AklRoman/Clever_predprof/Электроника/Архив/Монтажная схема компонентов турели.jpg

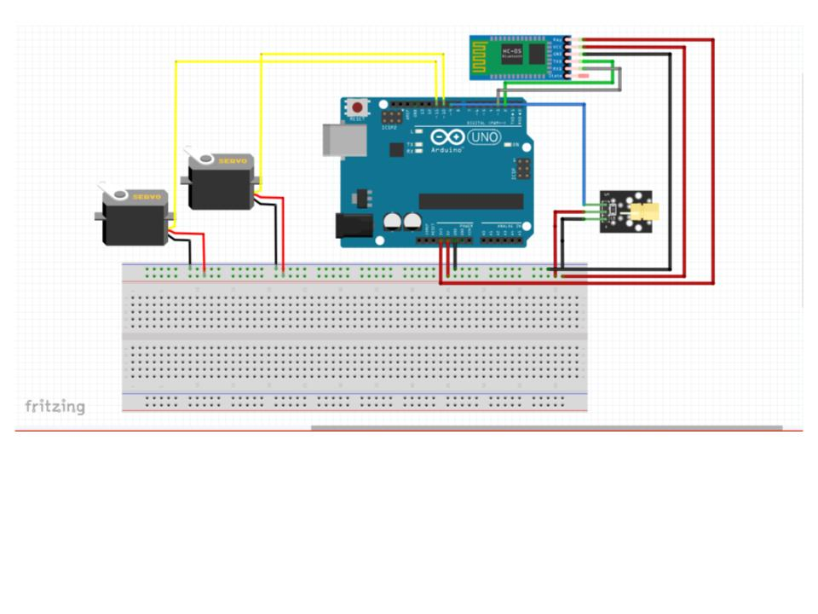
Электроника/Архив/Монтажная схема компонентов турели.jpg
