AklRoman/Clever_predprof/Электроника/Архив/Монтажная схема ардуино.docx

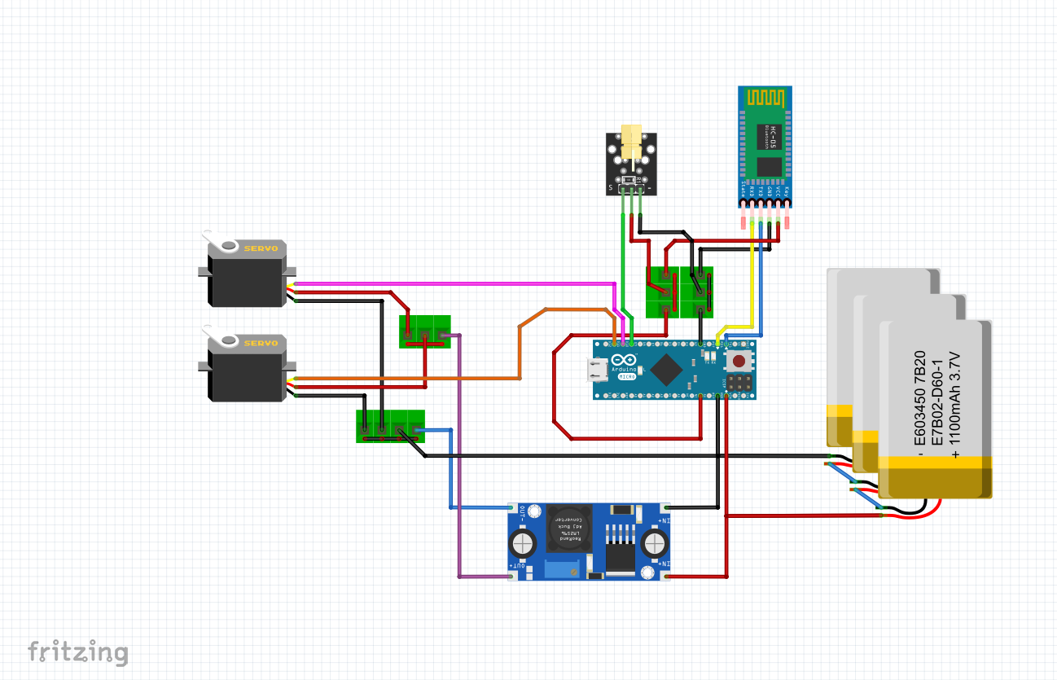
[picture p6: figure]
