AklRoman/Clever_predprof/Электроника/Архив/Монтажная схема турель.docx

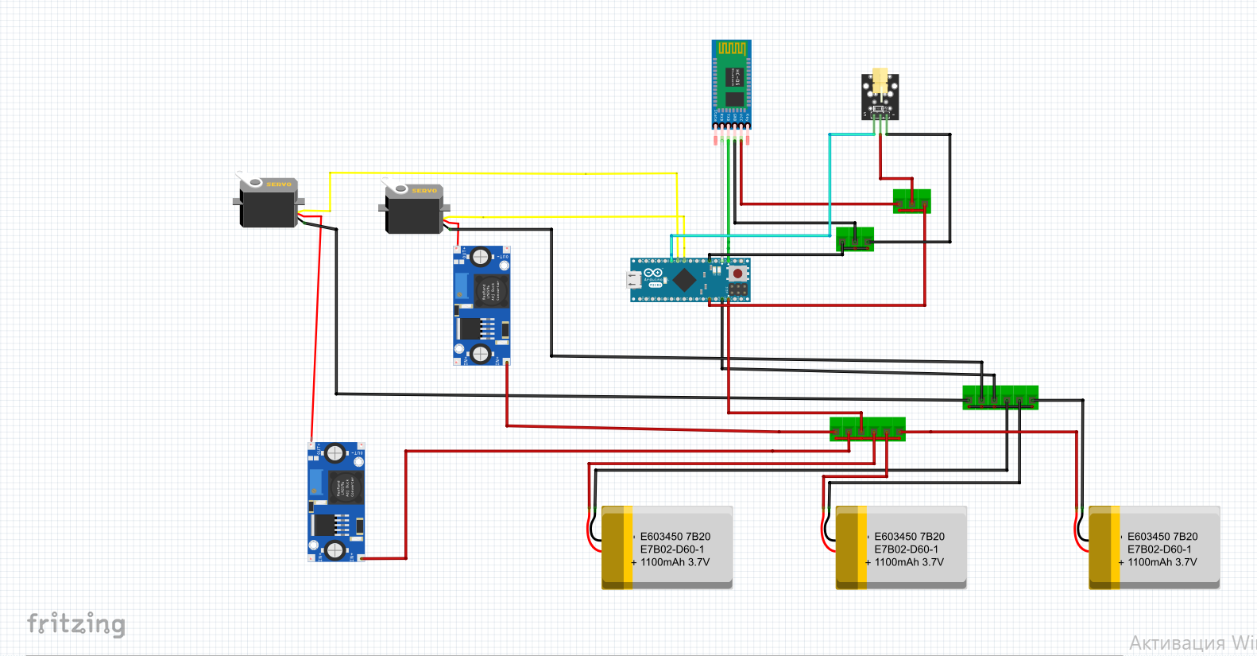
[picture p7: figure]
