AklRoman/Clever_predprof/Электроника/Архив/монтажная схема.docx

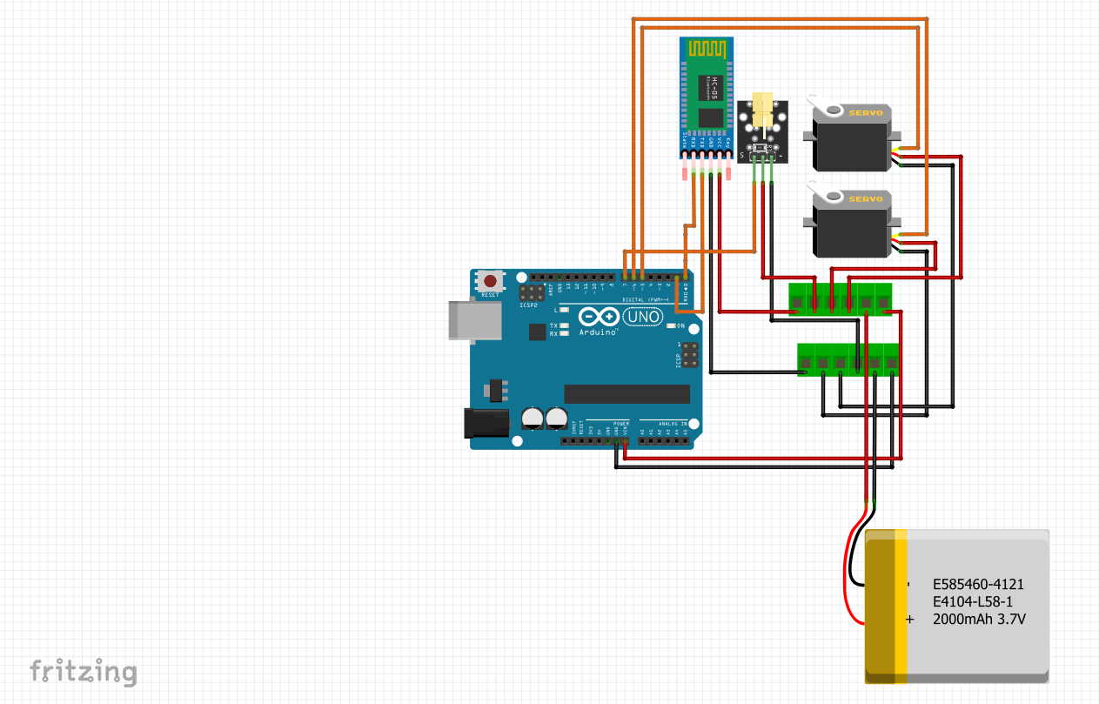
[picture p8: figure]
