AklRoman/Clever_predprof/ПО/PNG диаграммы состояний/State machine-Подсистема возврата.png

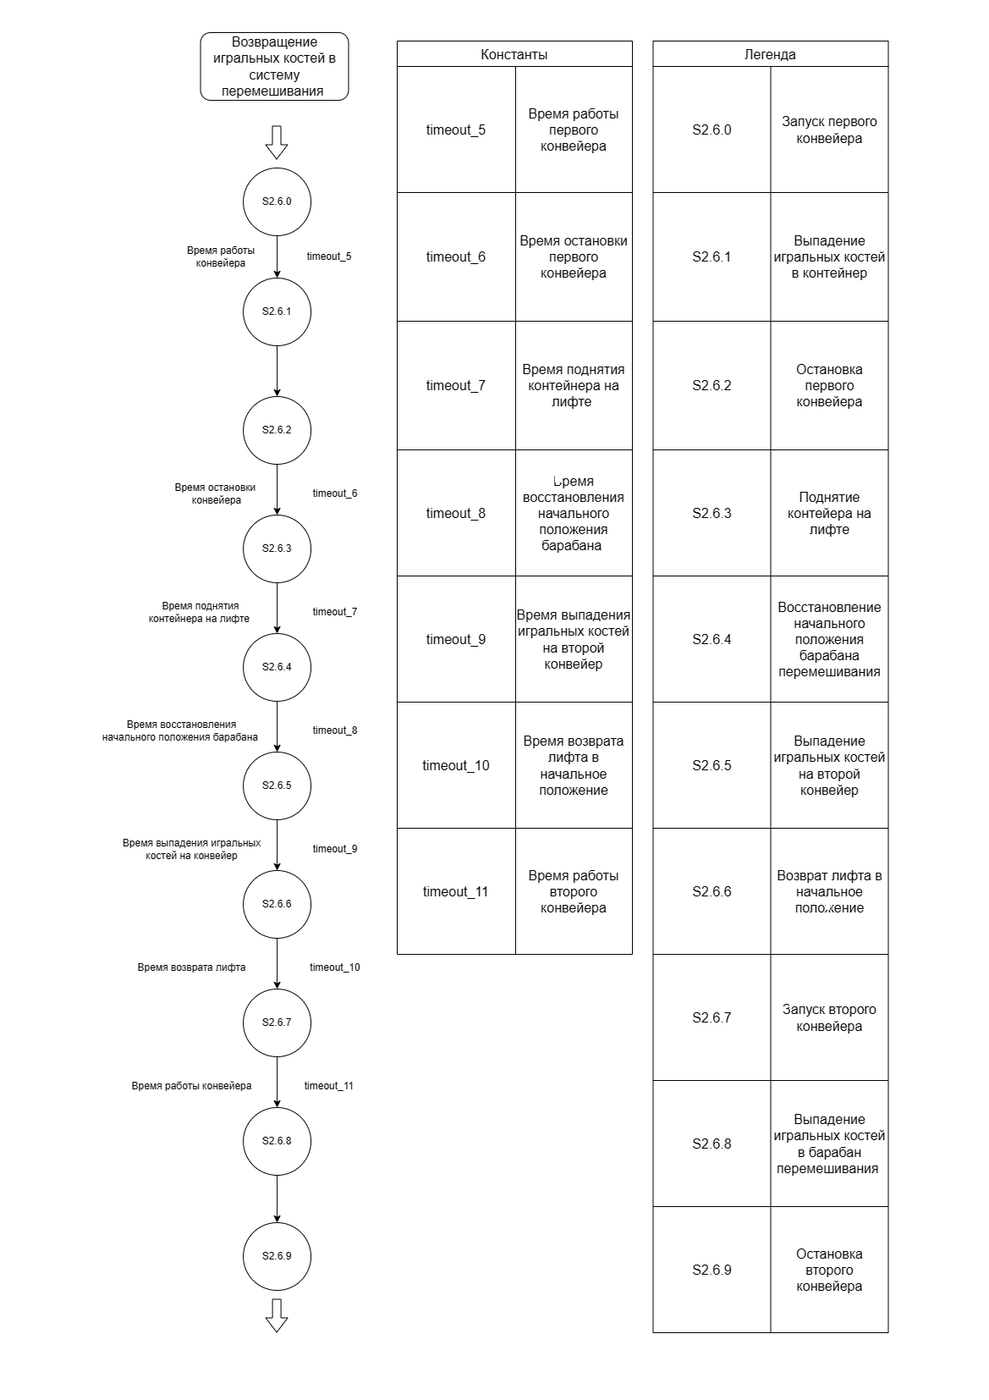
ПО/PNG диаграммы состояний/State machine-Подсистема возврата.png
