AklRoman/Clever_predprof/ПО/PNG диаграммы состояний/State machine-Проверка начального состояния.png

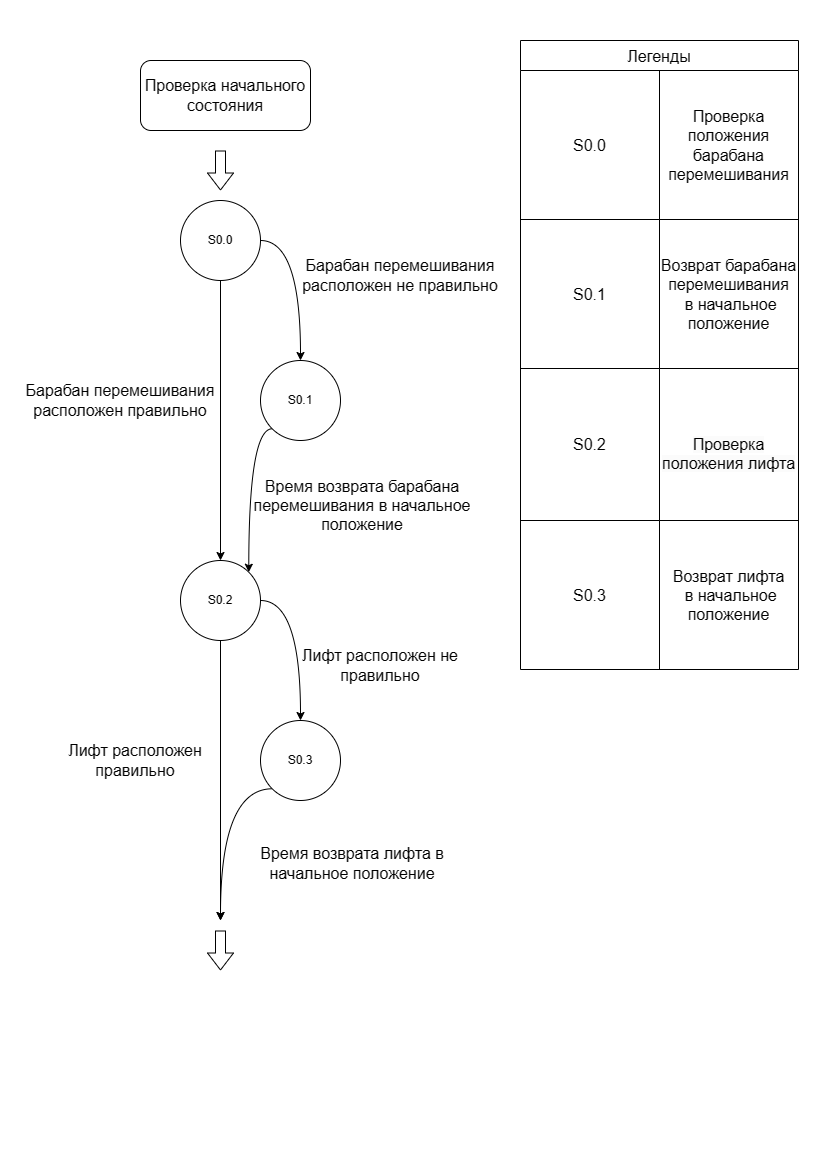
ПО/PNG диаграммы состояний/State machine-Проверка начального состояния.png
