AklRoman/Clever_predprof/ПО/PNG диаграммы состояний/State machine-Работа одного цикла.png

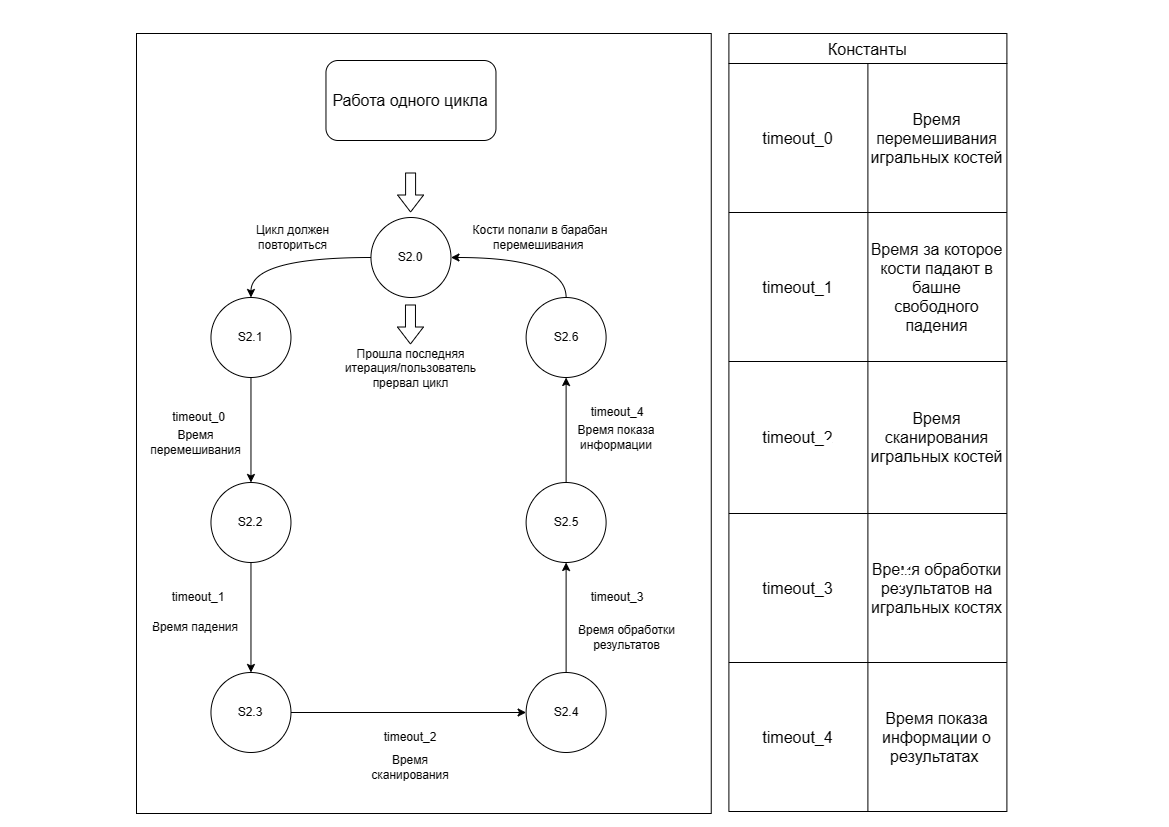
ПО/PNG диаграммы состояний/State machine-Работа одного цикла.png
