AklRoman/Clever_predprof/ПО/PNG диаграммы состояний/State machine-Разовые запуски подсистем.png

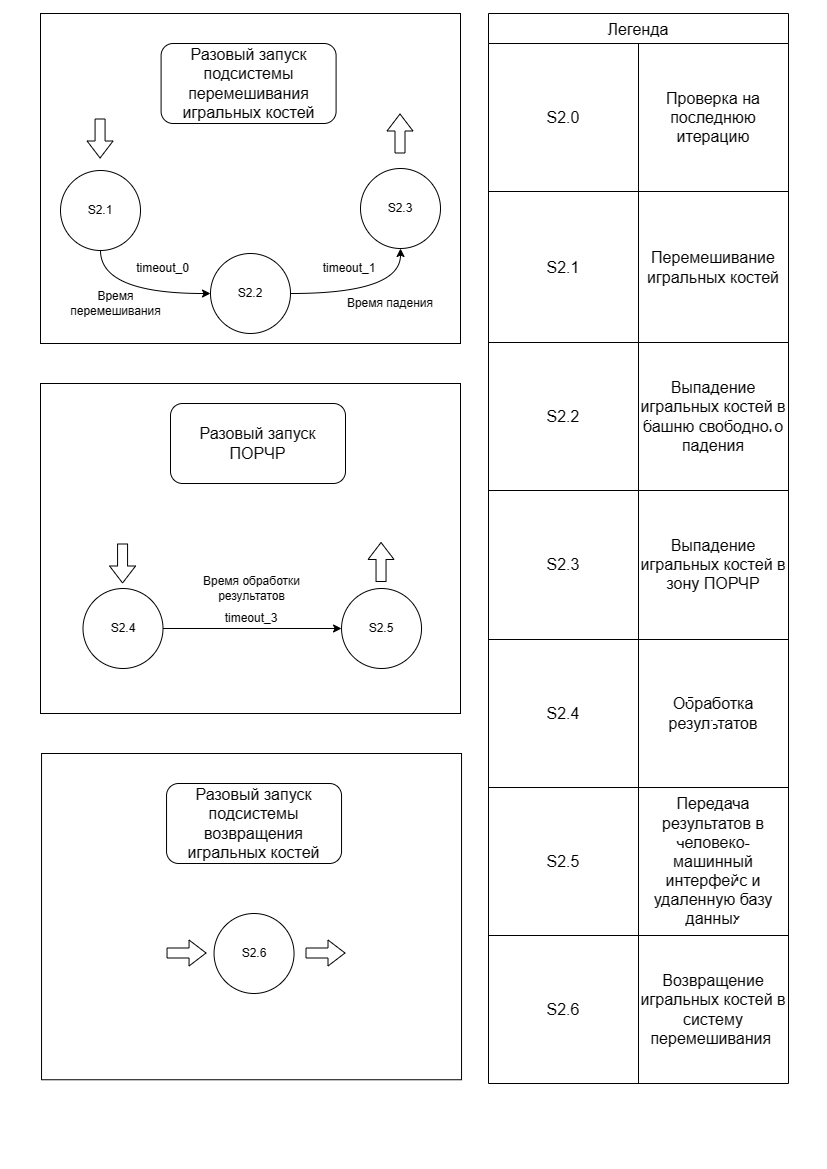
ПО/PNG диаграммы состояний/State machine-Разовые запуски подсистем.png
