AklRoman/Clever_predprof/ПО/PNG диаграммы состояний/State machine-Состояния, задаваемые пользователем.png

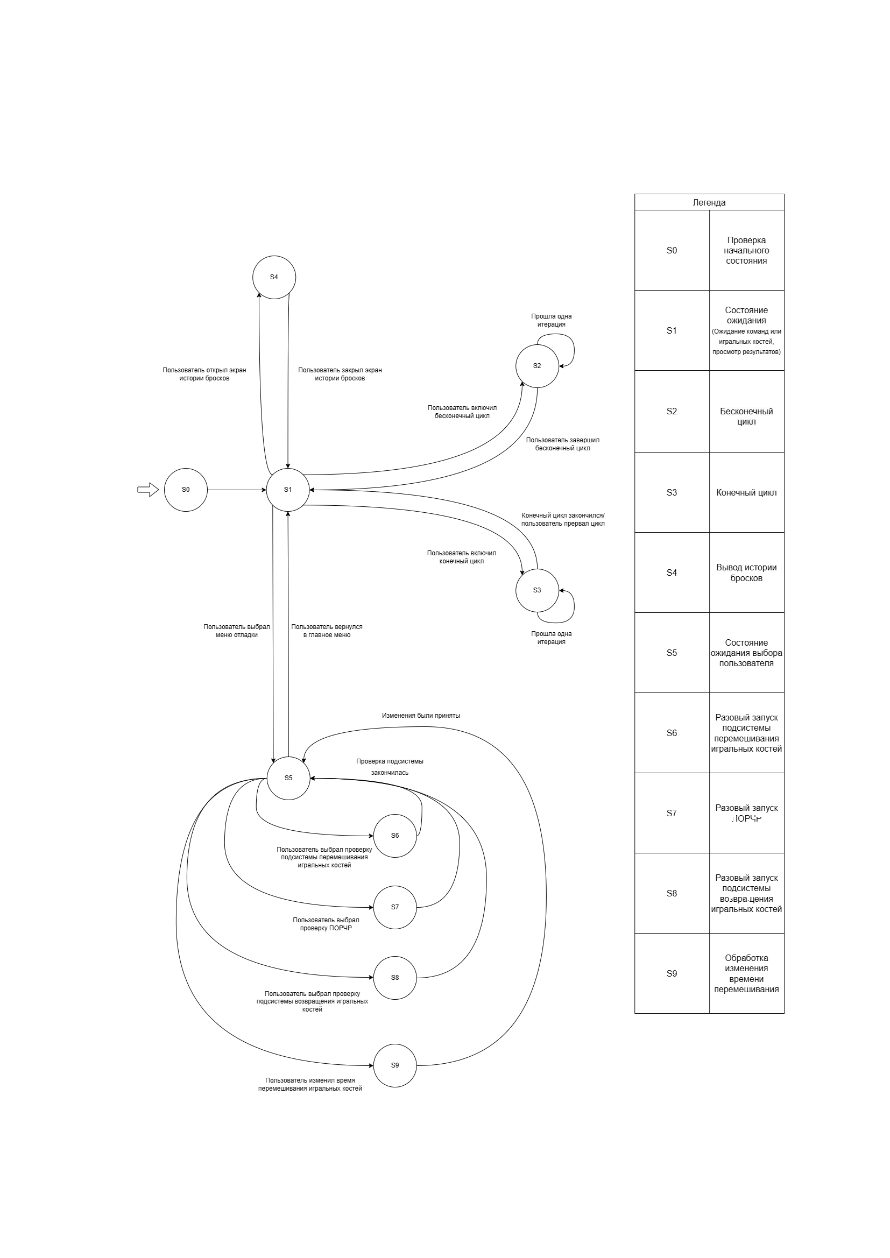
ПО/PNG диаграммы состояний/State machine-Состояния, задаваемые пользователем.png
