AklRoman/Clever_predprof/ПО/User case.png

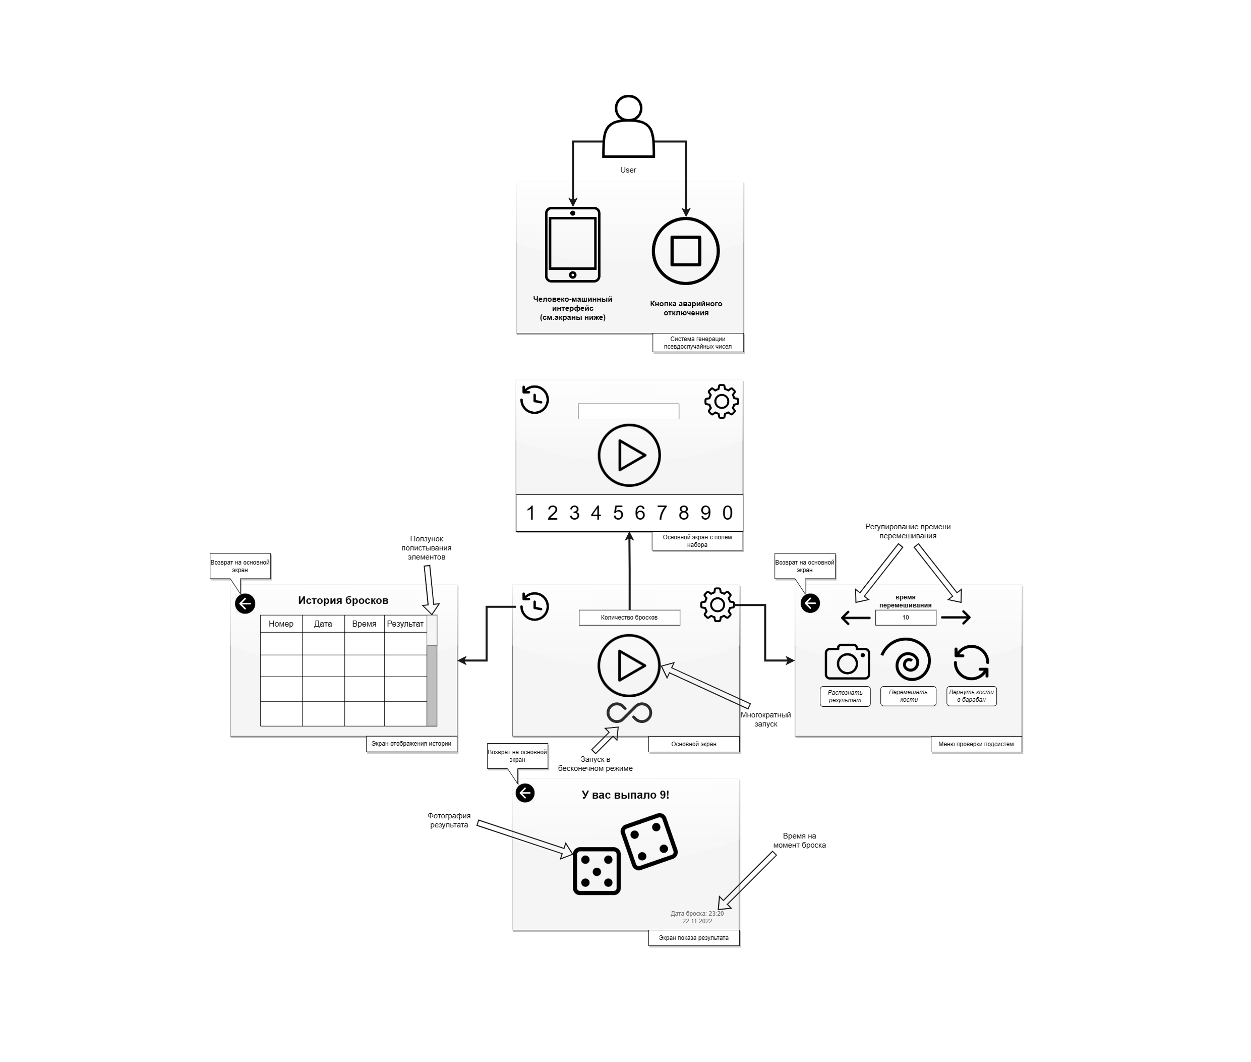
ПО/User case.png
