AklRoman/Clever_predprof/ПО/Блок-схемы/Блок-схема-onetimelaunch_ handler(cmd);.png

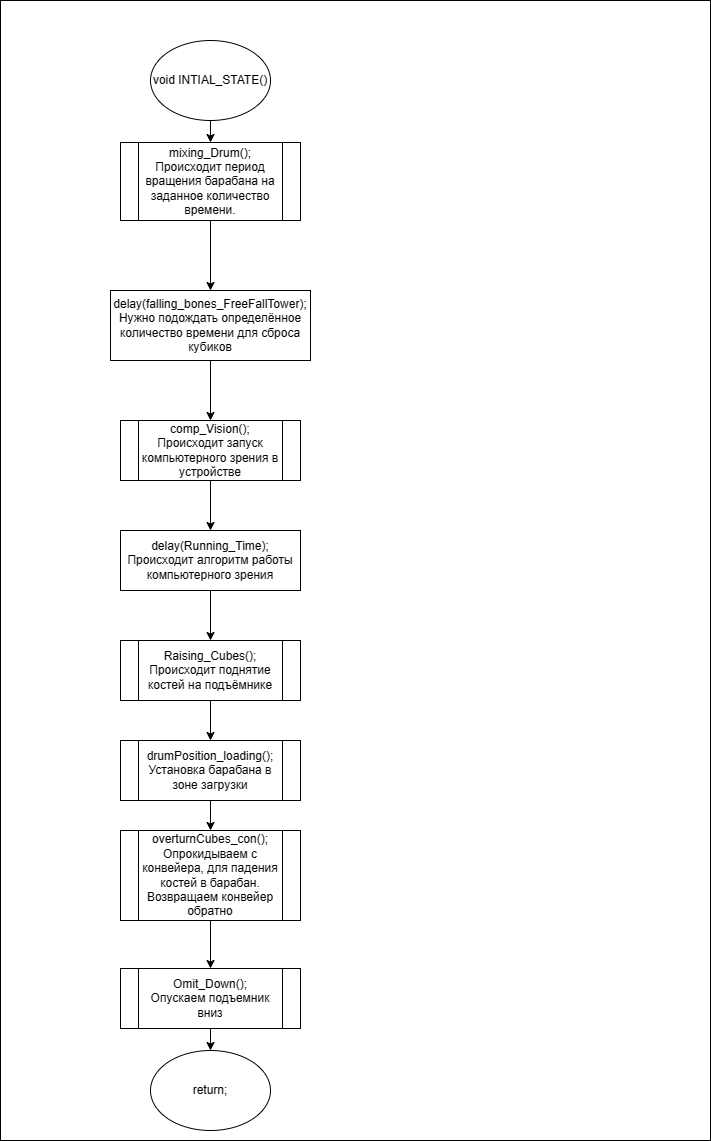
ПО/Блок-схемы/Блок-схема-onetimelaunch_ handler(cmd);.png
