AklRoman/Clever_predprof/ПО/Блок-схемы/Блок-схема-void loop().png

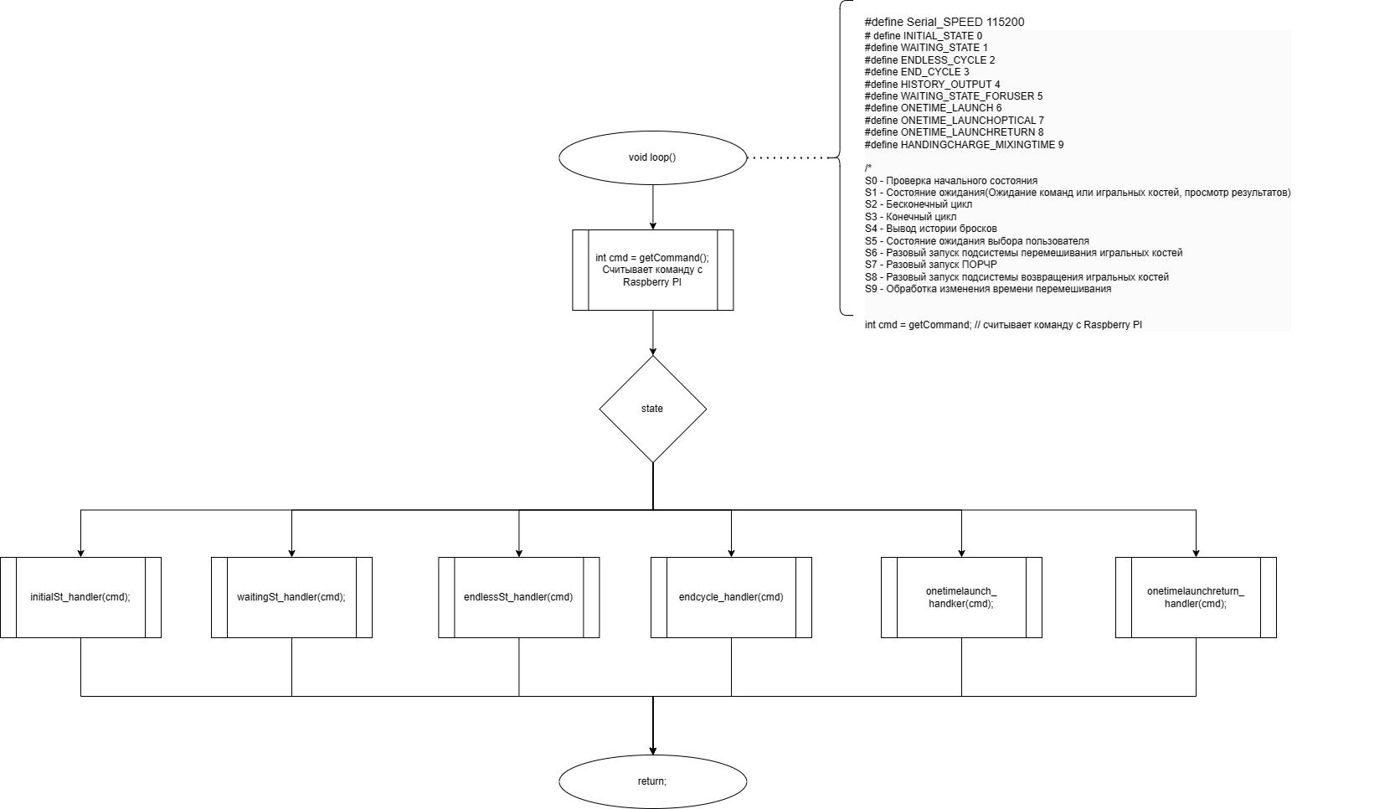
ПО/Блок-схемы/Блок-схема-void loop().png
