AklRoman/Clever_predprof/ПО/Диаграмма последовательности.drawio.png

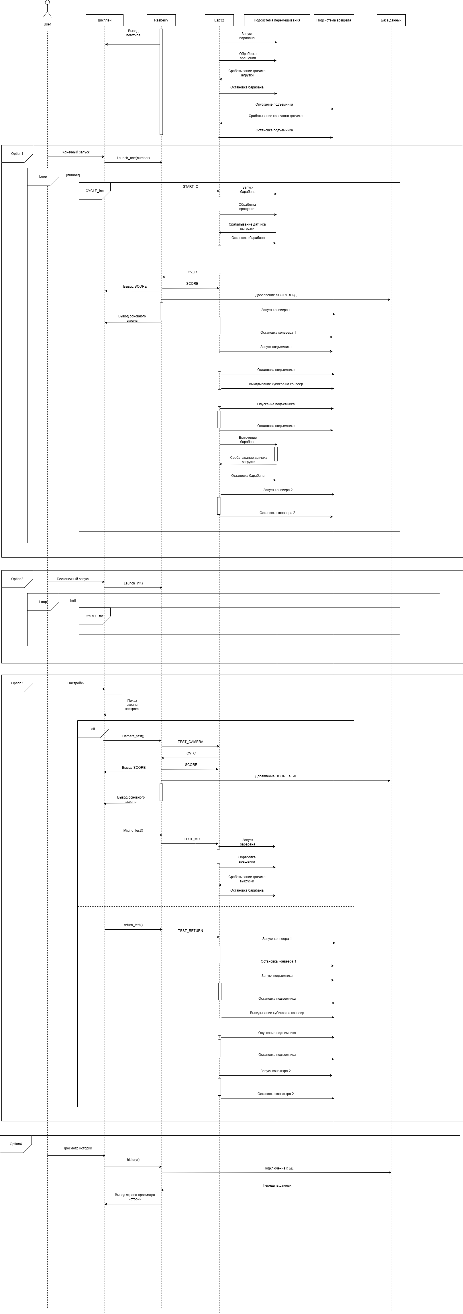
ПО/Диаграмма последовательности.drawio.png
