AklRoman/Clever_predprof/Электроника/Архив/Принципиальная схема компонентов турели.jpg

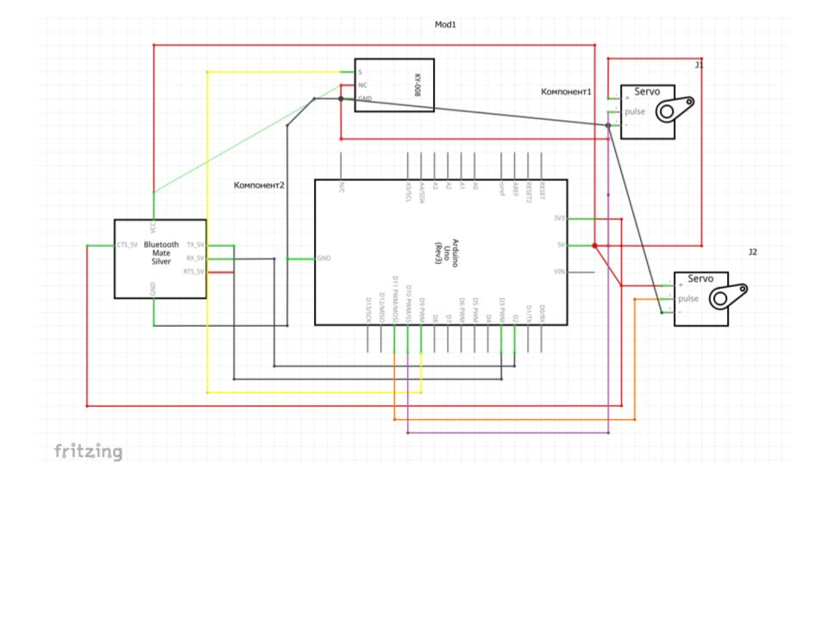
Электроника/Архив/Принципиальная схема компонентов турели.jpg
