AklRoman/Clever_predprof/(list of files, cad)

Other CAD files:
3D дизайн/сборка барабана v3.f3z
