AklRoman/Clever_predprof/Электроника/МС_МП.pdf

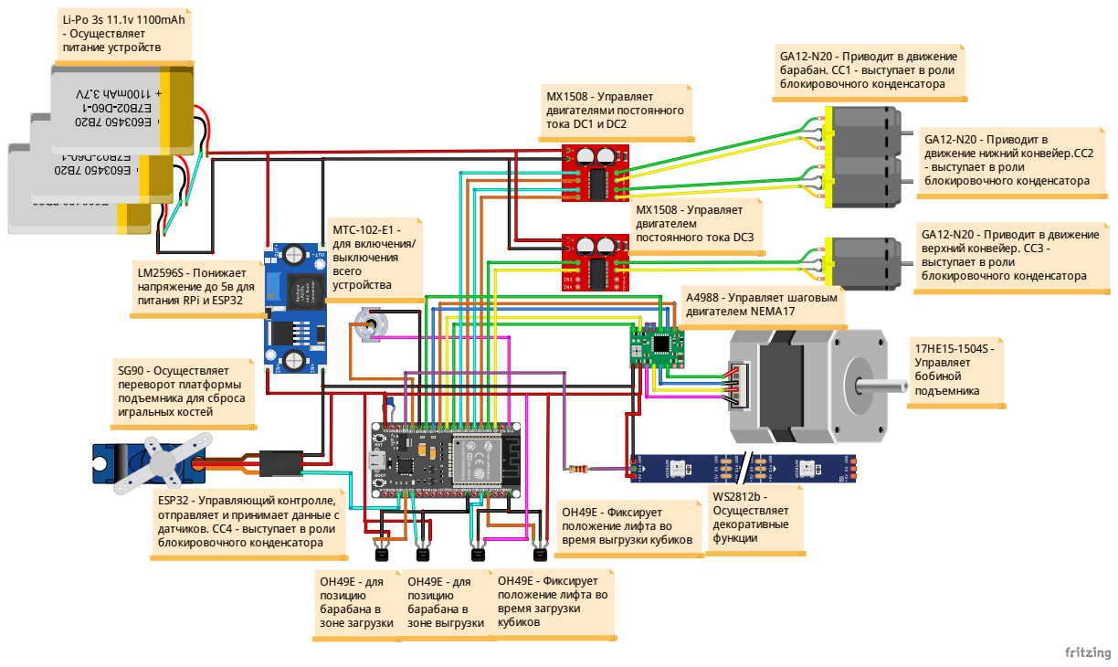
[picture p19: page 1]
Li-Po 3s 11.1v 1100mAh - Осуществляет питание устройств; MTC-102-E1 - для включения/ выключения всего устройства; OH49E - для позицию барабана в; зоне загрузки; зоне выгрузки; WS2812b - Осуществляет декоративные функции; MX1508 - Управляет двигателями постоянного тока DC1 и DC2; MX1508 - Управляет двигателем постоянного тока DC3; GA12-N20 - Приводит в движение верхний конвейер. CC3 -; выступает в роли блокировочного конденсатора; A4988 - Управляет шаговым двигателем NEMA17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

GA12-N20 - Приводит в движение
барабан. CC1 - выступает в роли
блокировочного конденсатора

GA12-N20 - Приводит в
движение нижний конвейер.CC2
- выступает в роли

LM2596S - Понижает
напряжение до 5в для
питания RPi и ESP32

SG90 - Осуществляет
переворот платформы
подъемника для сброса
игральных костей

ESP32 - Управляющий контролле,
отправляет и принимает данные с
датчиков. CC4 - выступает в роли

OH49E - Фиксирует
положение лифта во
время выгрузки кубиков

время загрузки
кубиков
