AklRoman/Clever_predprof/Электроника/ТЗ Принципиальная схема.pdf

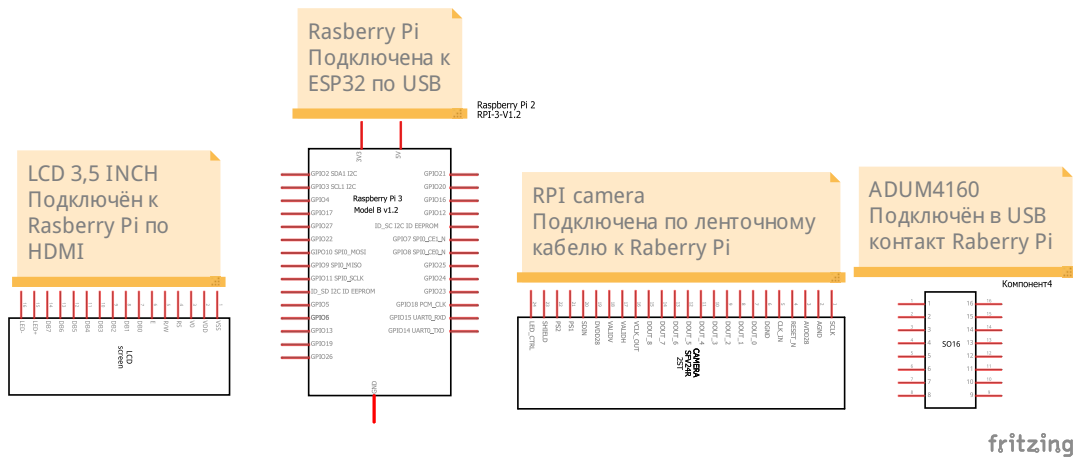
[picture p20: page 1]
Rasberry Pi Подключена к ESP32 по USB

LCD 3,5 INCH
Подключён к
Rasberry Pi по
HDMI

ADUM4160
Подключён в USB
контакт Raberry Pi

RPI camera
Подключена по ленточному
кабелю к Raberry Pi
