AklRoman/Clever_predprof/Электроника/Архив/Micro_МП.pdf

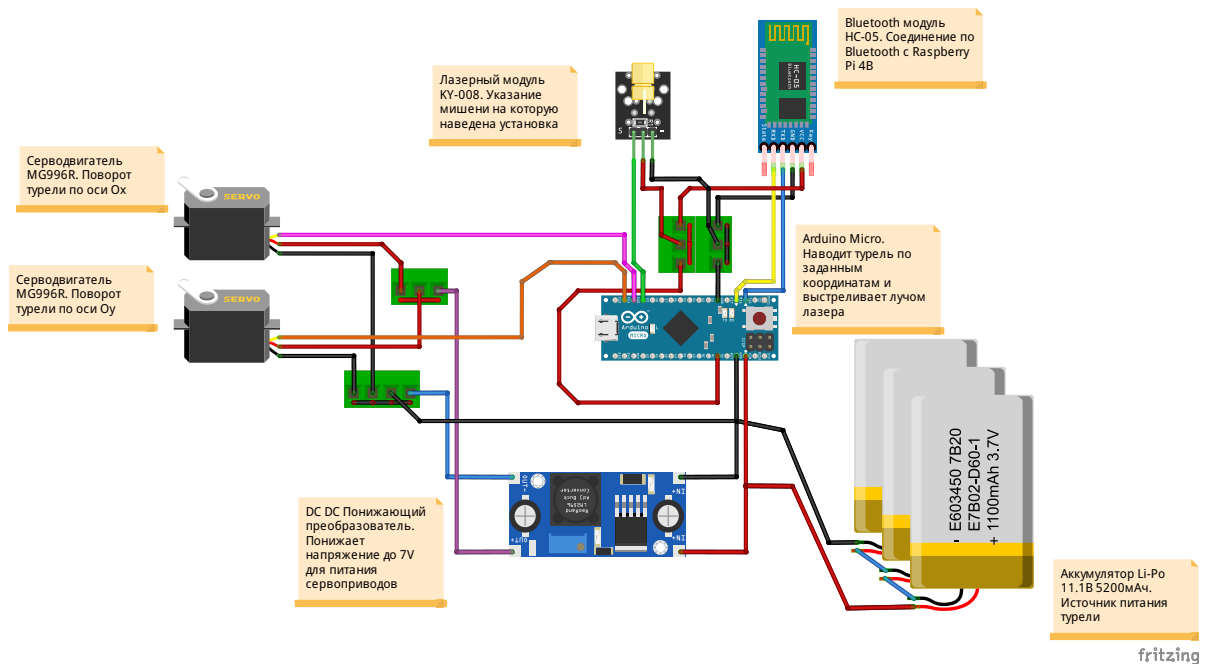
[picture p21: page 1]

Bluetooth модуль
HC-05. Соединение по
Bluetooth с Raspberry

Лазерный модуль
KY-008. Указание
мишени на которую
наведена установка

Серводвигатель
MG996R. Поворот
турели по оси Ox

Arduino Micro.
Наводит турель по
заданным
координатам и
выстреливает лучом
лазера

турели по оси Oy

DC DC Понижающий
преобразователь.
Понижает
напряжение до 7V
для питания
сервоприводов

Аккумулятор Li-Po
11.1В 5200мАч.
Источник питания
турели
