AklRoman/Clever_predprof/Электроника/Архив/Принципиальная схема.pdf

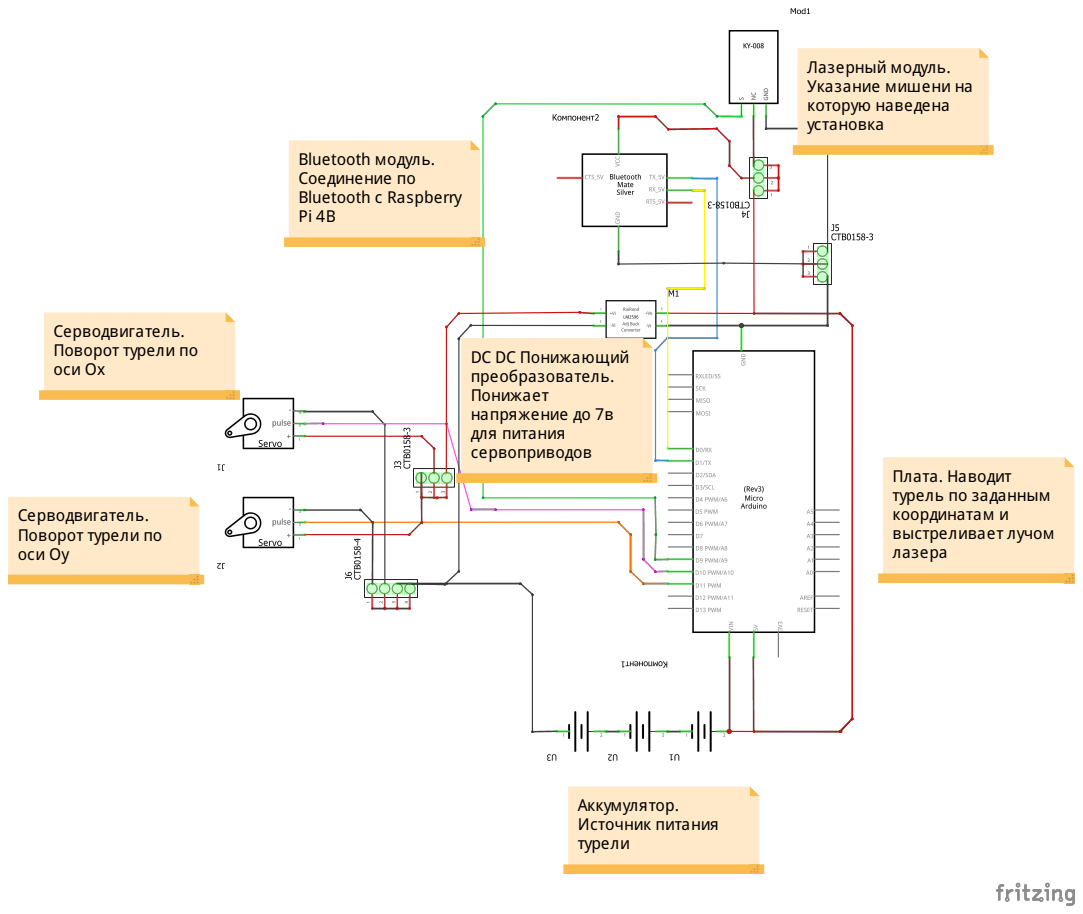
[picture p22: page 1]
Аккумулятор. Источник питания турели; Bluetooth модуль. Соединение по Bluetooth с Raspberry Pi 4B

Лазерный модуль.
Указание мишени на
которую наведена
установка

Серводвигатель.
Поворот турели по
оси Ox

DC DC Понижающий
преобразователь.
Понижает
напряжение до 7в
для питания
сервоприводов

Плата. Наводит
турель по заданным
координатам и
выстреливает лучом
лазера

оси Oy
