AklRoman/Clever_predprof/Электроника/Принципильаная схема.pdf

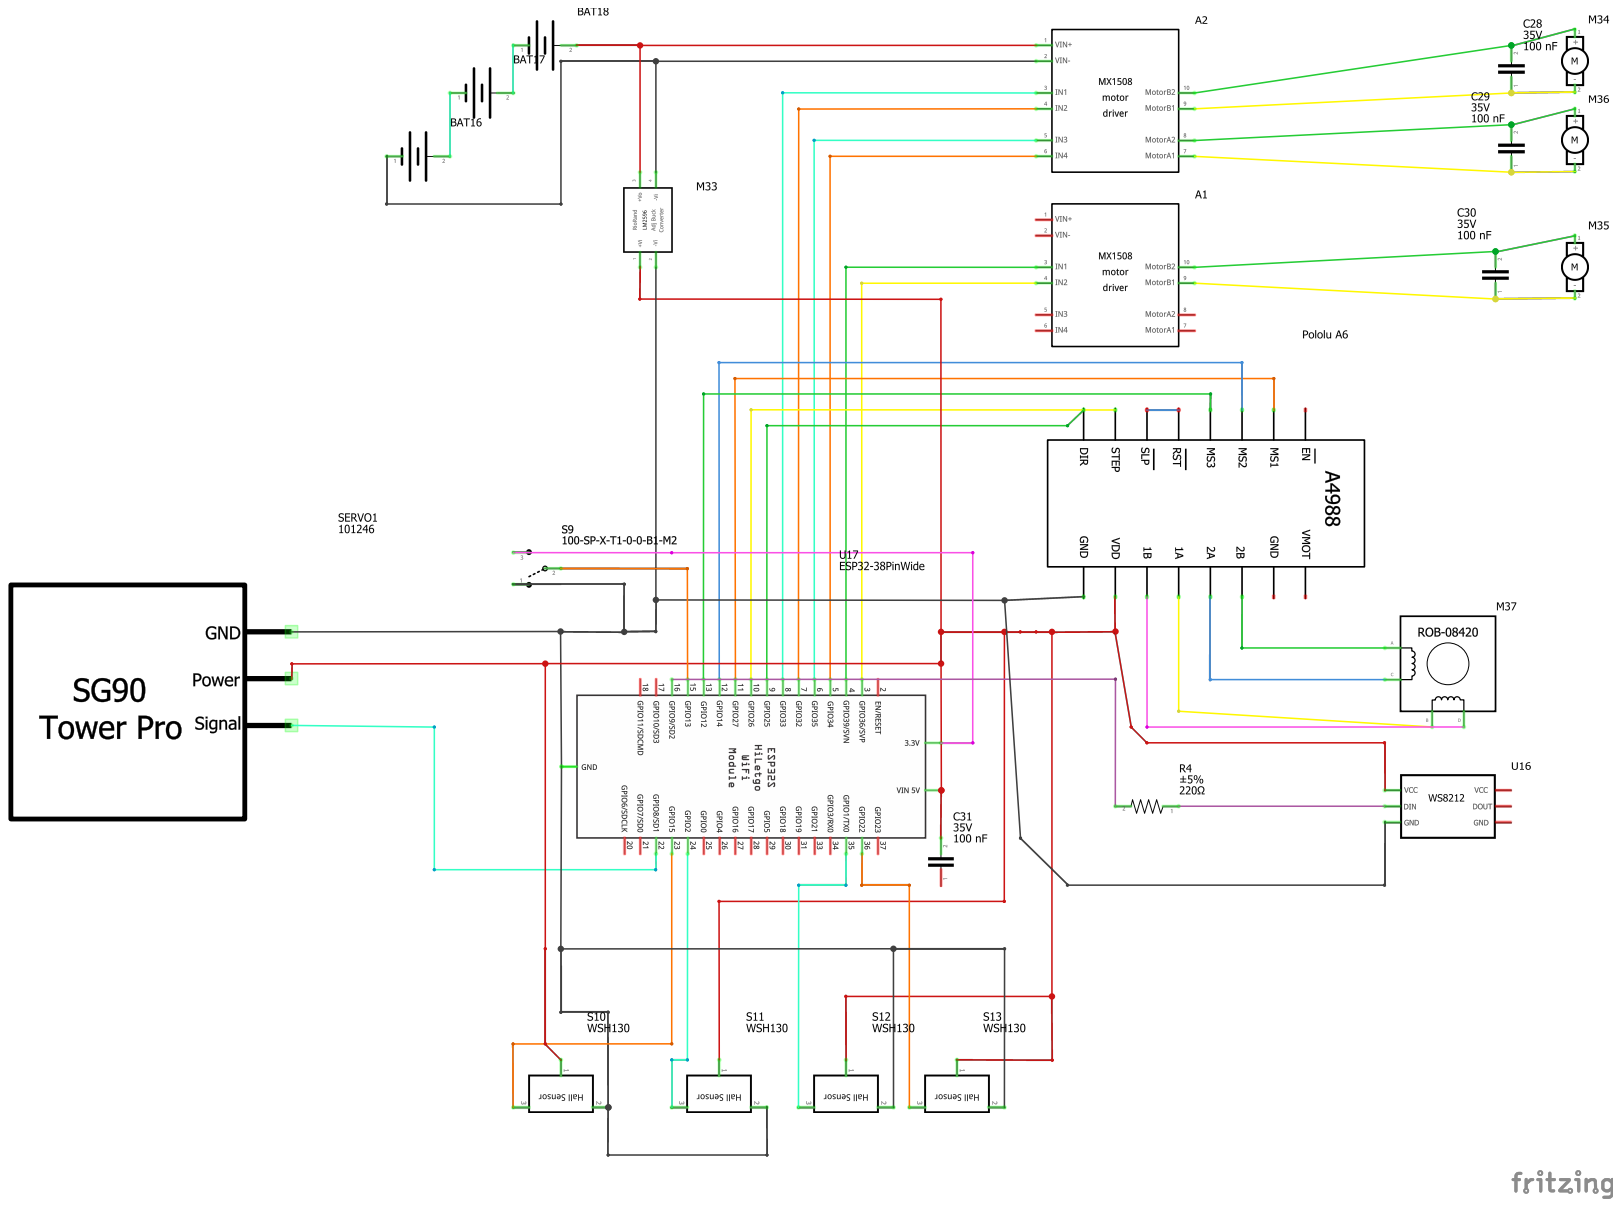
[picture p23: page 1]
