AklRoman/Clever_predprof/Электроника/Система ТЗ МП.pdf

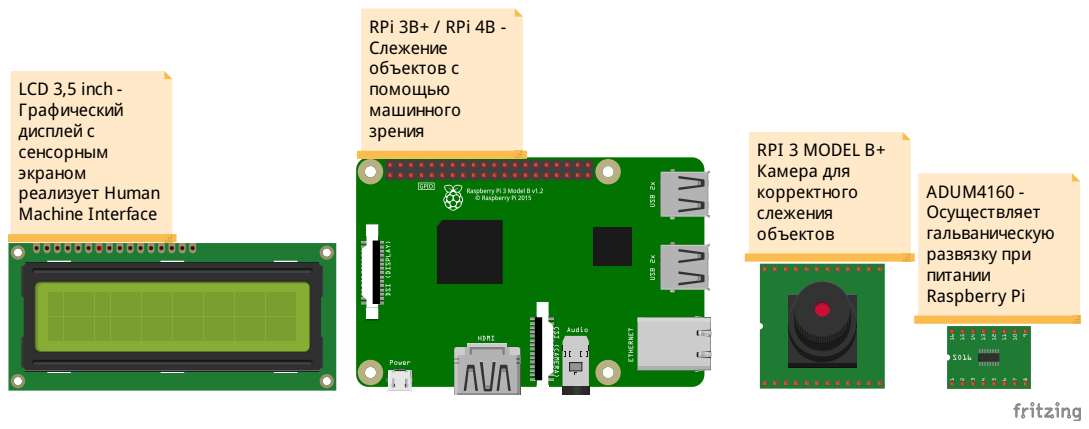
[picture p24: page 1]
Pi LCD 3,5 inch - Графический дисплей с сенсорным экраном реализует Human Machine Interface; RPi 3B+ / RPi 4B - Слежение объектов с помощью машинного зрения
