AklRoman/Clever_predprof/(list of files, drawings)

Other design files:
Электроника/Архив/h.fzz
Электроника/Архив/Micro.fzz
Электроника/Архив/Принципиальная схема.fzz
Электроника/Исходник Системы ТЗ.fzz
Электроника/МС.fzz
Электроника/Принципиальная схема.fzz
Электроника/ТЗ исходник прицниальной схемы.fzz
